puhitaku/nintendo-switch-i2s-to-spdif/img/social.jpg

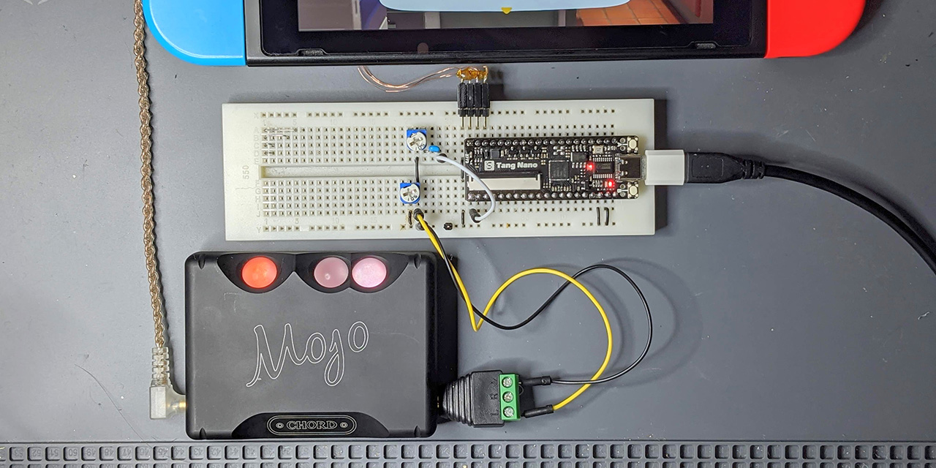
img/social.jpg
