puhitaku/nintendo-switch-i2s-to-spdif/impl/pnr/device.cfg

set JTAG regular_io = false
set SSPI regular_io = true
set MSPI regular_io = true
set READY regular_io = false
set DONE regular_io = false
set RECONFIG_N regular_io = false
set MODE regular_io = false
set CRC_check = true
set compress = false
set encryption = false
set security_bit_enable = true
set bsram_init_fuse_print = true
set background_programming = false
set secure_mode = false
set download_speed = 240/96
set wake_up = 0
set spi_flash_address = 0x00FFF000
set format = txt
