puhitaku/nintendo-switch-i2s-to-spdif/src/fifo/fifo.v

//
//Written by GowinSynthesis
//Product Version "GowinSynthesis V1.9.3.02Beta"
//Thu Aug 13 03:32:08 2020

//Source file index table:
//file0 "\/home/takumi/dev/tangnano/i2s2spdif/src/fifo/temp/FIFO/fifo_define.v"
//file1 "\/home/takumi/dev/tangnano/i2s2spdif/src/fifo/temp/FIFO/fifo_parameter.v"
//file2 "\/home/takumi/.gowin/IDE/ipcore/FIFO/data/edc.v"
//file3 "\/home/takumi/.gowin/IDE/ipcore/FIFO/data/fifo.v"
//file4 "\/home/takumi/.gowin/IDE/ipcore/FIFO/data/fifo_top.v"
`timescale 100 ps/100 ps
`pragma protect begin_protected
`pragma protect version=1
`pragma protect author="default"
`pragma protect author_info="default"
`pragma protect encrypt_agent="Synplify encryptP1735.pl"
`pragma protect encrypt_agent_info="Synplify encryptP1735.pl Version 1.1"

`pragma protect encoding=(enctype="base64", line_length=76, bytes=256)
`pragma protect key_keyowner="Synplicity",key_keyname="SYNP05_001",key_method="rsa"
`pragma protect key_block
YVOYkpG4UA/dYdlBUn8N0lqyFVbrkrfLEJcBc5eV95GJWNvZIv06Ycs0bCmImhipM+QYwkAtC5od
8zRdjJy2vCZzBOg2AUCIeejeDe5aqRMrYE8LlPl7hZM76WdpvVJ1JYRKg+fiEyRe+6S3T8wQmuOP
8RlwJACjP4bWuF8QgRTBKV6AGYK6ORFCcHaOWnwoD1/SiYPs7yKH5FsBv3kob7+dXKf1LeiZ9egF
occHwP+tSfzAkdsKSx0ktjxyU1Tlz27mkD0Go7GbKLkja4mAnRbXYU8ooFFvto63aJgXt1eobmqK
O4U90FPh/oR/A+VwuWSmXrYCeGZiyMXKWA194Q==

`pragma protect encoding=(enctype="base64", line_length=76, bytes=256)
`pragma protect key_keyowner="GoWin",key_keyname="GoWin001",key_method="rsa"
`pragma protect key_block
L9S/38jc9oLEenc3he8cBhgvssr/MTbaITrGelx7Cm9Q2VXAxoIaQHCvVBP+KWb7BQXFWhAu8DS2
ZXkWWqZKo3XhF3bBI8tMoJJx8N4Es0flYywV9cxhGGyKTqWkkDM2atUhwkdRKYBl7rbo7tT8VZtY
JTnUOimhNLRLCwx4sygOfxXnz/gFo7aB4gCGM+6DhO+ea98U/jZi8nLI8teVIPxMC/+4oC3D8Obh
dZjXvLZk0tuyWVtcsZBD3dFAwtGp5RYTY6nSU+Fm/5i2Lrn11gJwyIaTmj8yWmpUjoxDVwA45hhj
YUHpEnCC9TMAbnG3i3gbOXE6TgOfZa8iFd6OkQ==

`pragma protect encoding=(enctype="base64", line_length=76, bytes=49664)
`pragma protect data_keyowner="default-ip-vendor"
`pragma protect data_keyname="default-ip-key"
`pragma protect data_method="aes128-cbc"
`pragma protect data_block
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
PcpNDrd8XGC3FqFjoy7M+6Q=
`pragma protect end_protected
module fifo ( Data,Reset,WrClk,RdClk,WrEn,RdEn,Q,Almost_Full,Empty,Full);
input [31:0] Data;
input Reset;
input WrClk;
input RdClk;
input WrEn;
input RdEn;
output [31:0] Q;
output Almost_Full;
output Empty;
output Full;
wire VCC;
wire GND;
\fifo/fifo_inst  fifo_inst (
  .RdClk(RdClk),
  .RdEn(RdEn),
  .WrClk(WrClk),
  .\Data[0] (Data[0]),
  .\Data[1] (Data[1]),
  .\Data[2] (Data[2]),
  .\Data[3] (Data[3]),
  .\Data[4] (Data[4]),
  .\Data[5] (Data[5]),
  .\Data[6] (Data[6]),
  .\Data[7] (Data[7]),
  .\Data[8] (Data[8]),
  .\Data[9] (Data[9]),
  .\Data[10] (Data[10]),
  .\Data[11] (Data[11]),
  .\Data[12] (Data[12]),
  .\Data[13] (Data[13]),
  .\Data[14] (Data[14]),
  .\Data[15] (Data[15]),
  .\Data[16] (Data[16]),
  .\Data[17] (Data[17]),
  .\Data[18] (Data[18]),
  .\Data[19] (Data[19]),
  .\Data[20] (Data[20]),
  .\Data[21] (Data[21]),
  .\Data[22] (Data[22]),
  .\Data[23] (Data[23]),
  .\Data[24] (Data[24]),
  .\Data[25] (Data[25]),
  .\Data[26] (Data[26]),
  .\Data[27] (Data[27]),
  .\Data[28] (Data[28]),
  .\Data[29] (Data[29]),
  .\Data[30] (Data[30]),
  .\Data[31] (Data[31]),
  .Reset(Reset),
  .WrEn(WrEn),
  .\Q[31] (Q[31]),
  .\Q[30] (Q[30]),
  .\Q[29] (Q[29]),
  .\Q[28] (Q[28]),
  .\Q[27] (Q[27]),
  .\Q[26] (Q[26]),
  .\Q[25] (Q[25]),
  .\Q[24] (Q[24]),
  .\Q[23] (Q[23]),
  .\Q[22] (Q[22]),
  .\Q[21] (Q[21]),
  .\Q[20] (Q[20]),
  .\Q[19] (Q[19]),
  .\Q[18] (Q[18]),
  .\Q[17] (Q[17]),
  .\Q[16] (Q[16]),
  .\Q[15] (Q[15]),
  .\Q[14] (Q[14]),
  .\Q[13] (Q[13]),
  .\Q[12] (Q[12]),
  .\Q[11] (Q[11]),
  .\Q[10] (Q[10]),
  .\Q[9] (Q[9]),
  .\Q[8] (Q[8]),
  .\Q[7] (Q[7]),
  .\Q[6] (Q[6]),
  .\Q[5] (Q[5]),
  .\Q[4] (Q[4]),
  .\Q[3] (Q[3]),
  .\Q[2] (Q[2]),
  .\Q[1] (Q[1]),
  .\Q[0] (Q[0]),
  .Empty(Empty),
  .Full(Full),
  .Almost_Full(Almost_Full) 
);
  VCC VCC_cZ (
  .V(VCC)
);
  GND GND_cZ (
  .G(GND)
);
endmodule /* fifo */
