puhitaku/nintendo-switch-i2s-to-spdif/(commit log)

2020-08-12 Add initial files
    [device.cfg, pnr.cfg, synthesize.cfg]
2020-08-14 Add wire guide image
